Arcane-Dream/First_systems_check/nfa20_door_adapter/plan.png

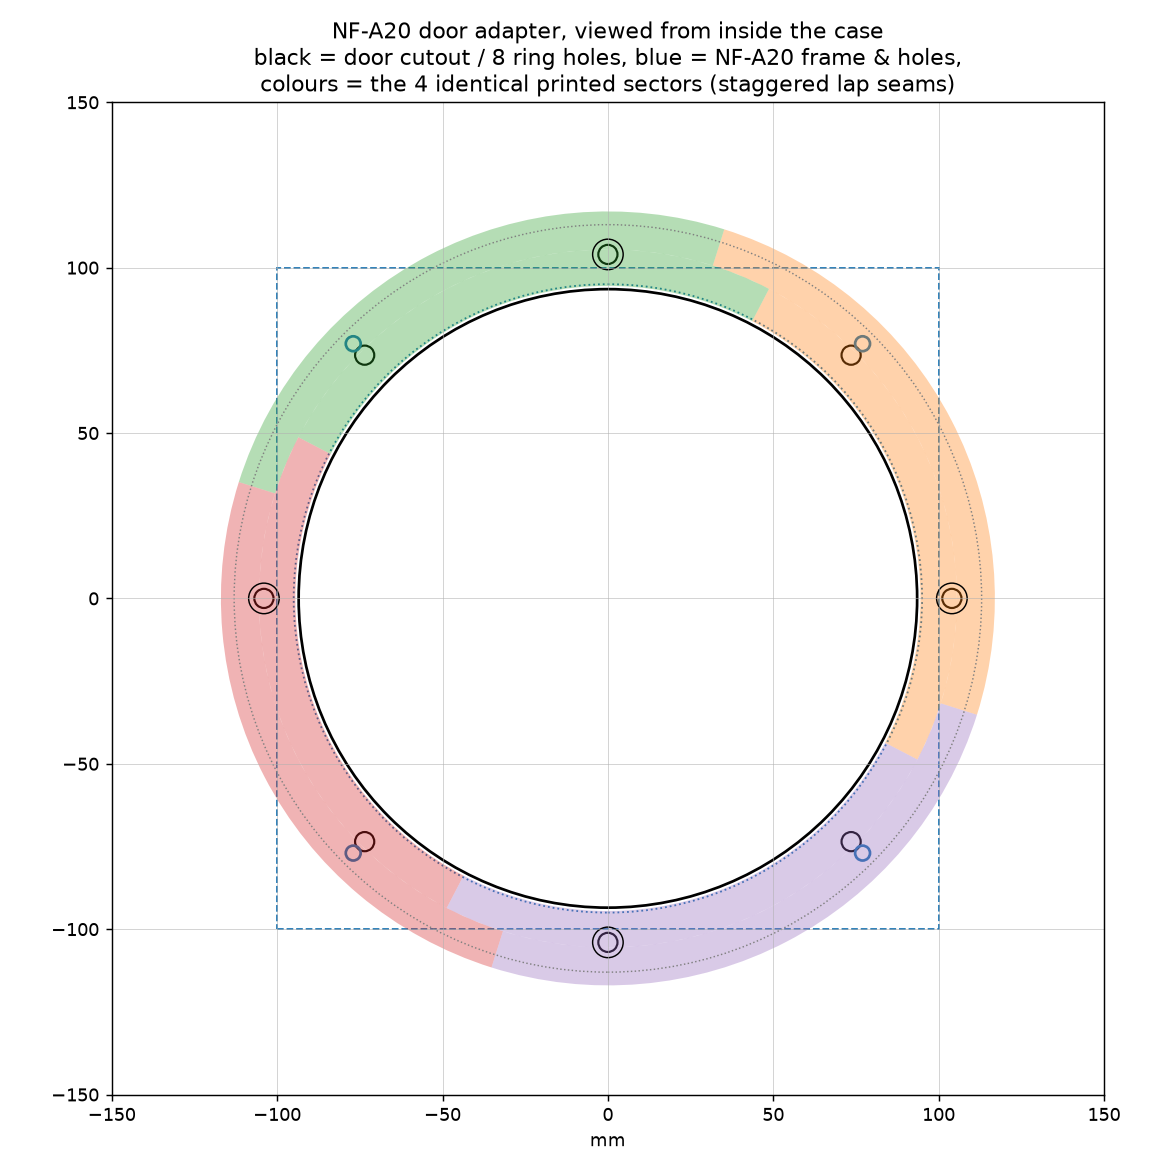
nfa20_door_adapter/plan.png
