Arcane-Dream/First_systems_check/nfa20_door_adapter/preview/renders.png

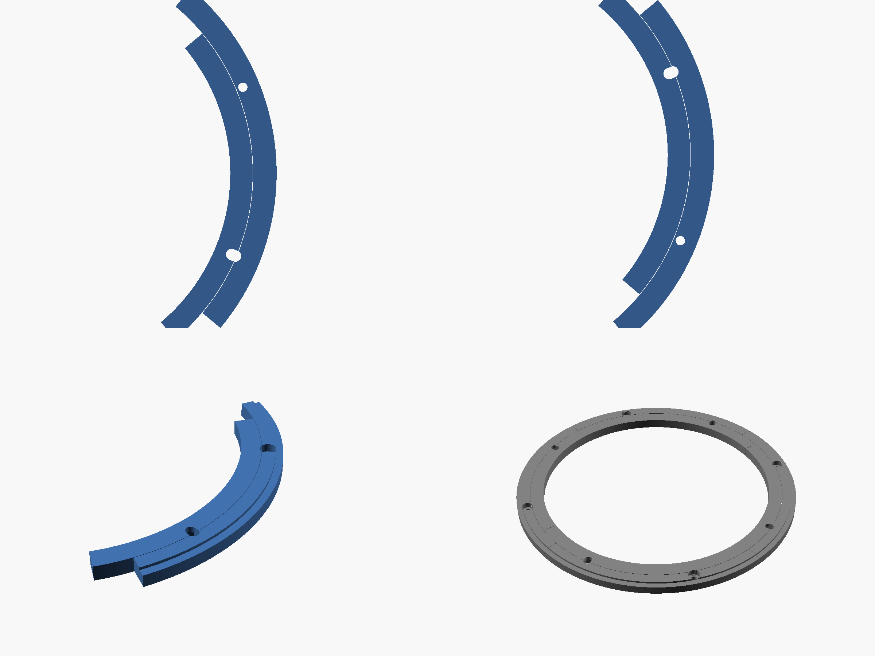
nfa20_door_adapter/preview/renders.png
