Arcane-Dream/First_systems_check/nfa20_door_adapter/preview/renders_v2.png

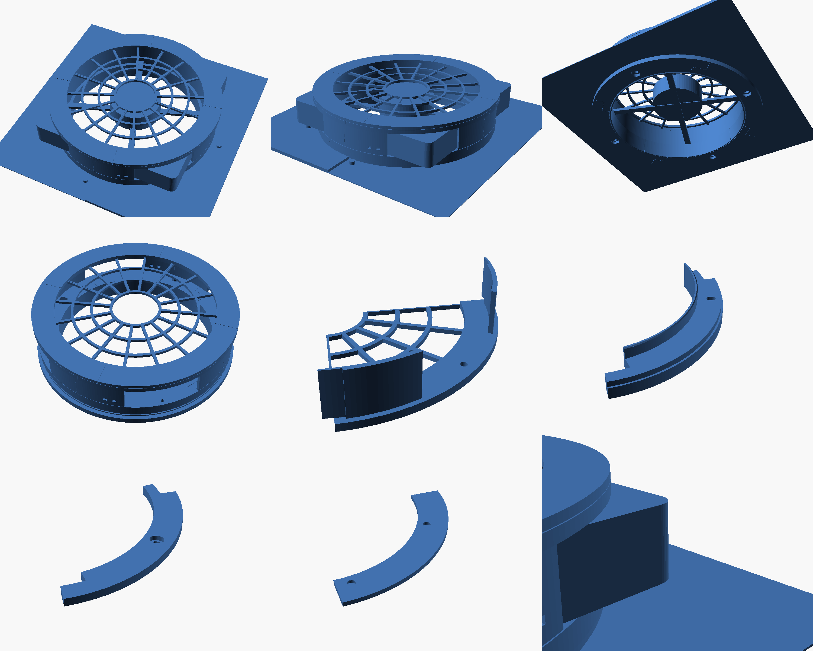
nfa20_door_adapter/preview/renders_v2.png
