Arcane-Dream/First_systems_check/nfa20_door_adapter/stl_v2/assembly_with_fan_and_door_preview.stl

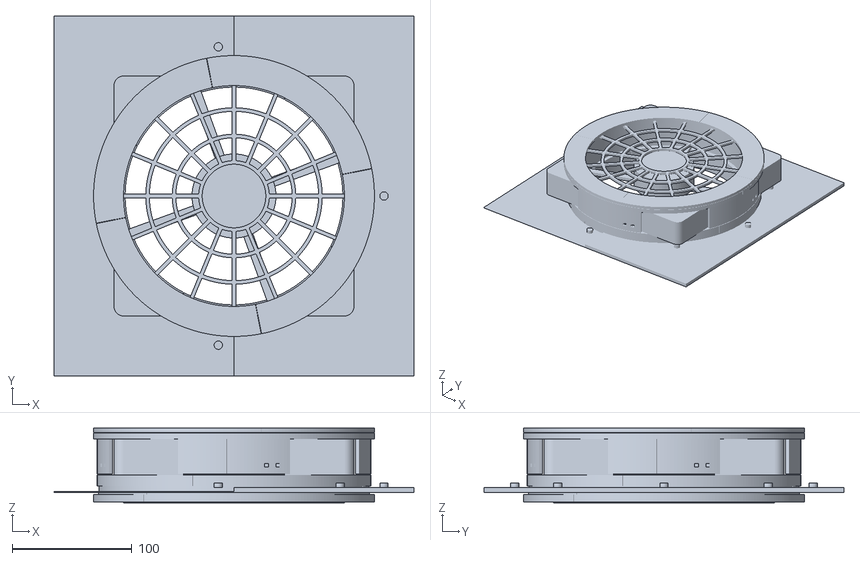
[picture p7: CAD file, 2026-10-01]
nfa20_door_adapter/stl_v2/assembly_with_fan_and_door_preview.stl
300.0 x 300.0 x 62.2
