Arcane-Dream/First_systems_check/nfa20_door_adapter/stl_v2/assembly_printed_parts_preview.stl

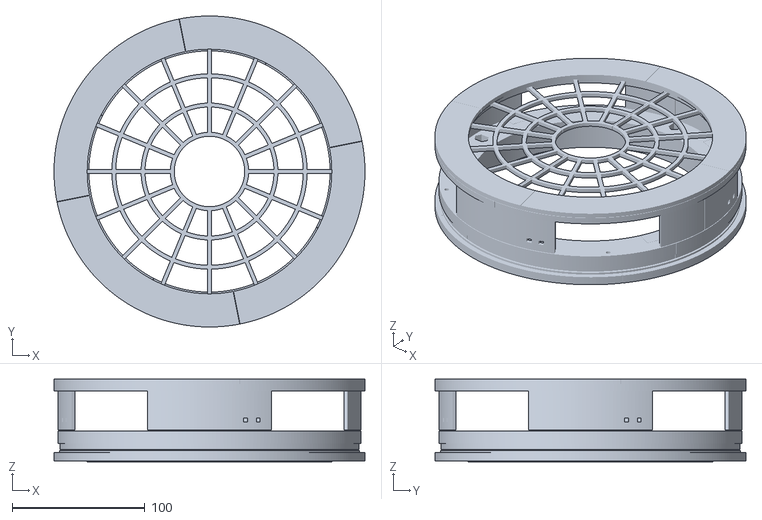
[picture p8: CAD file, 2026-10-01]
nfa20_door_adapter/stl_v2/assembly_printed_parts_preview.stl
234.0 x 234.0 x 62.2
