Arcane-Dream/First_systems_check/nfa20_door_adapter/stl_v2/bezel_sector_x4.stl

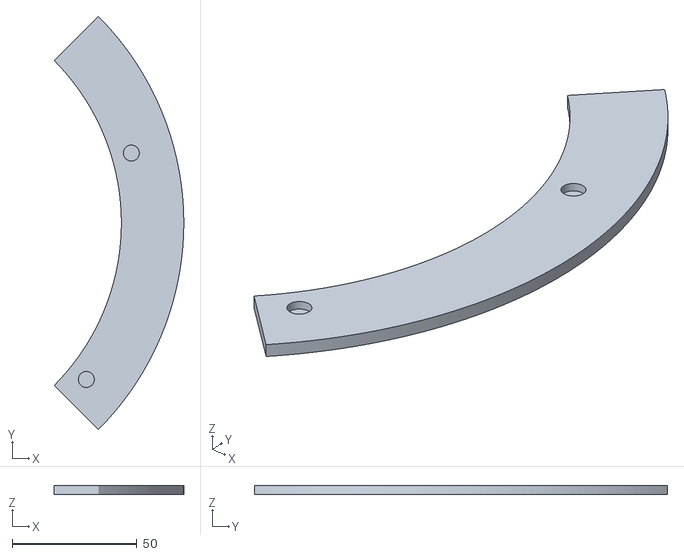
[picture p9: CAD file, 2026-10-01]
nfa20_door_adapter/stl_v2/bezel_sector_x4.stl
51.8 x 165.2 x 3.50
