Arcane-Dream/First_systems_check/nfa20_door_adapter/stl_v2/inner_ring_sector_x4.stl

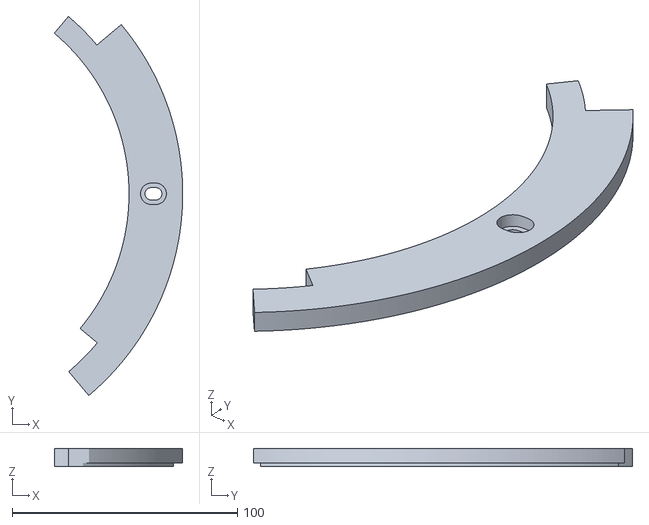
[picture p10: CAD file, 2026-10-01]
nfa20_door_adapter/stl_v2/inner_ring_sector_x4.stl
57.0 x 168.3 x 8.00
