Arcane-Dream/First_systems_check/nfa20_door_adapter/stl_v2/housing_quadrant_x4.stl

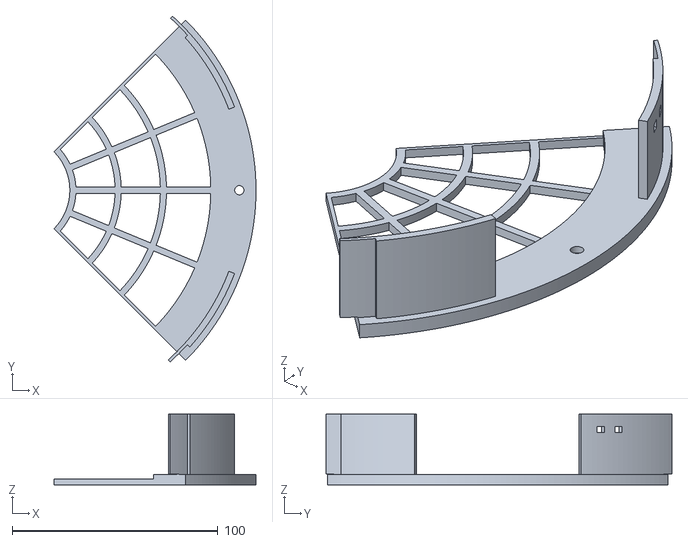
[picture p11: CAD file, 2026-10-01]
nfa20_door_adapter/stl_v2/housing_quadrant_x4.stl
98.2 x 168.1 x 34.5
