Arcane-Dream/First_systems_check/nfa20_door_adapter/stl_v2/flange_sector_x4.stl

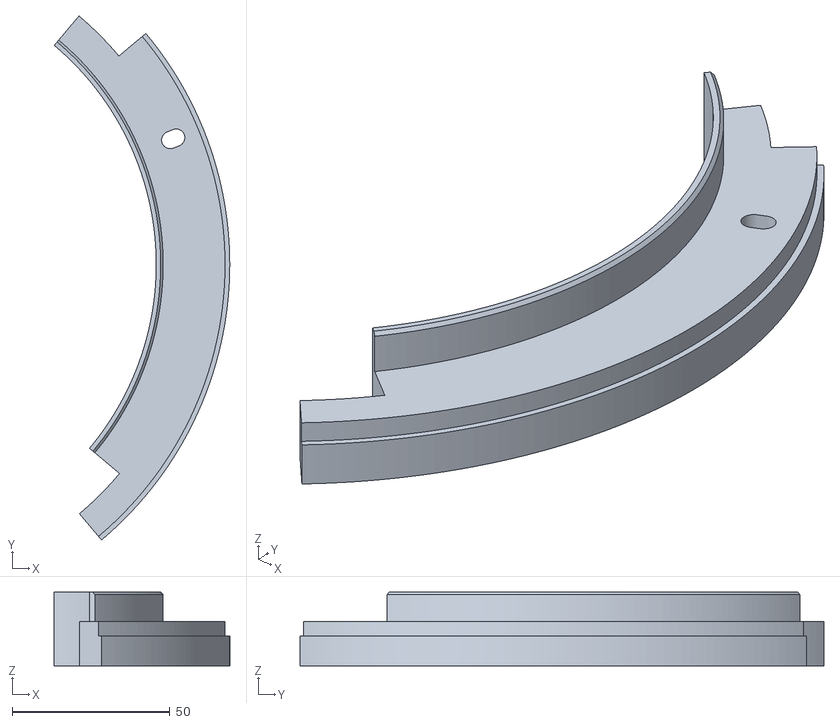
[picture p12: CAD file, 2026-10-01]
nfa20_door_adapter/stl_v2/flange_sector_x4.stl
55.6 x 166.0 x 23.4
