Arcane-Dream/First_systems_check/nfa20_door_adapter/stl/nfa20_door_adapter_assembled_preview.stl

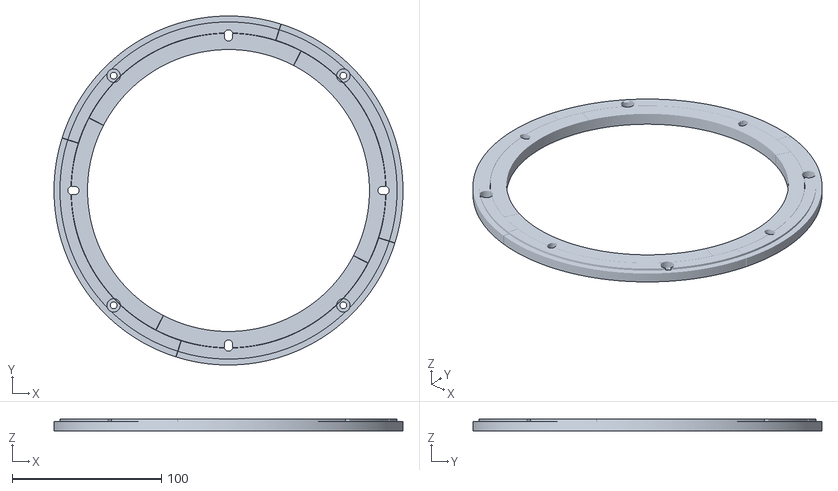
[picture p13: CAD file, 2026-09-30, an earlier design]
nfa20_door_adapter/stl/nfa20_door_adapter_assembled_preview.stl
234.0 x 234.0 x 8.00
