Arcane-Dream/First_systems_check/nfa20_door_adapter/stl/nfa20_door_adapter_sector_x4.stl

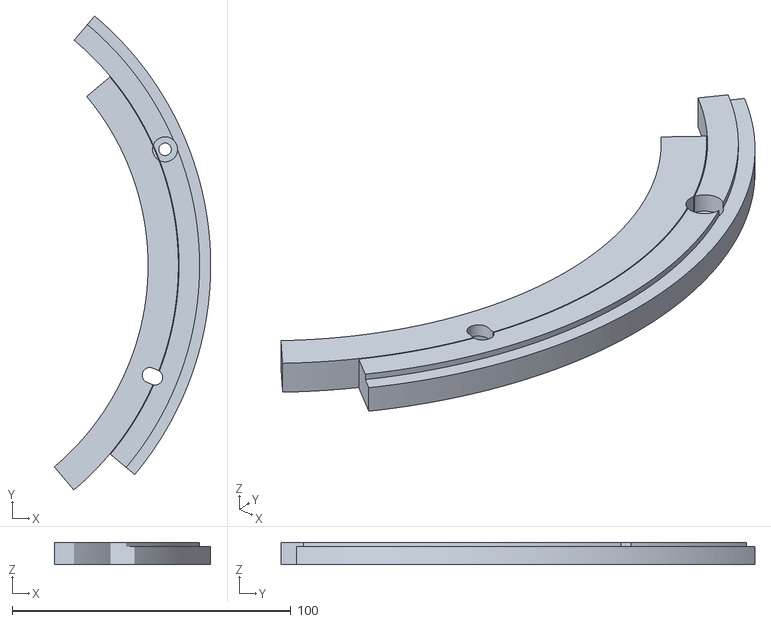
[picture p14: CAD file, 2026-09-30, an earlier design]
nfa20_door_adapter/stl/nfa20_door_adapter_sector_x4.stl
56.2 x 170.2 x 8.00
