Arcane-Dream/First_systems_check/(commit log)

2026-09-30 Add NF-A20 case-door fan adapter (4-sector printable ring)
    Adapter ring mounting a Noctua NF-A20 over the door's 187 mm cutout using
    the 208 mm 8-hole bolt ring. Bolts to the four orthogonal ring holes
    (M5 + captured nut), carries the fan on the diagonal 154 mm pattern, and
    prints as four identical interlocking sectors for a 180 mm bed.
    Includes the STLs, the OpenSCAD and Python/manifold3d sources (verified
    to produce the identical solid), a plan drawing, renders, and a README
    with the dimension derivation, hardware list, print and assembly notes.
    Claude-Session: https://claude.ai/code/session_0189vNpzXrhinC8eQ5nv5ttC
    [nfa20_door_adapter.scad, nfa20_door_adapter_assembled_preview.stl, nfa20_door_adapter_sector_x4.stl]
2026-09-30 Add v2 external NF-A20 door housing with dust filter and cable window
    Outside-mounted housing for the Noctua NF-A20 on the case door: 210 mm
    square base plinth using the door's orthogonal ring holes (M5 from
    inside into captured nuts), skirt with lap-jointed corner pieces, spoke
    grille front plate, magnetic mesh bezel, and a cable window with tie
    slots at the bottom-left corner for the external lead to the rear
    grommet. All parts split to print on an A1 mini.
    Geometry is driven by a perspective fit of the photos (acrylic edge at
    r 114.7, cap nuts on r 125) so the plinth clears the acrylic step and
    its fasteners. Python/manifold3d and OpenSCAD sources produce identical
    solids; interference a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
    [assembly_printed_parts_preview.stl, assembly_with_fan_and_door_preview.stl, bezel_sector_x4.stl, flange_sector_x4.stl, housing_corner_cable_x1.stl, housing_corner_x3.stl, nfa20_door_housing.scad]
2026-10-01 Clamp the housing to the cutout edge: collar plus inner backing ring
    The plinth now carries a 185.8 mm collar that drops through the 187 mm
    cutout, and a new four-piece inner ring on the inside of the door bolts
    to the plinth through the orthogonal ring holes, so the steel's hole
    edge is clamped between two rings and the collar takes shear and
    centring. Housing widened to 226 mm so the M5 nut pockets at r 104 are
    fully enclosed (a 2D section showed them breaking out of the 210 mm
    edge); the skirt screw-tip notch is no longer needed.
    Interference against door, fan, acrylic, cap nuts and between all part
    families is zero; OpenSCAD and Python sources produce identical solids.
    Adds a cross-sect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
    [assembly_printed_parts_preview.stl, assembly_with_fan_and_door_preview.stl, bezel_sector_x4.stl, flange_sector_x4.stl, housing_corner_cable_x1.stl, housing_corner_x3.stl, inner_ring_sector_x4.stl, nfa20_door_housing.scad]
2026-10-01 Round housing inside the acrylic edge; make every sector a single solid
    Plinth is now a round ring (r 90.7 to 114) that follows the acrylic
    window's inner edge, with a cylindrical skirt, round grille plate and
    bezel; the fan's corners pass through four windows in the skirt so
    nothing covers the acrylic. The fan is held by four M4 x 40 screws from
    the front through its corner holes into blind holes in the plinth,
    since a round plinth has no room for counterbores from underneath.
    Fixes the sector builder: the seam clearance was being applied between
    a piece's own inner and outer bands, leaving every plinth and inner
    ring sector as two shells 0.25 mm apart. Bands now overlap inside the
    body an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
    [assembly_printed_parts_preview.stl, assembly_with_fan_and_door_preview.stl, bezel_sector_x4.stl, flange_sector_x4.stl, housing_corner_cable_x1.stl, housing_corner_x3.stl, housing_quadrant_x4.stl, inner_ring_sector_x4.stl]
